ElaadNL/LowPowerLora-v4/Arduino_RFM95.kicad_pcb

## KiCad design Arduino_RFM95.kicad_pcb (2019-10-10)

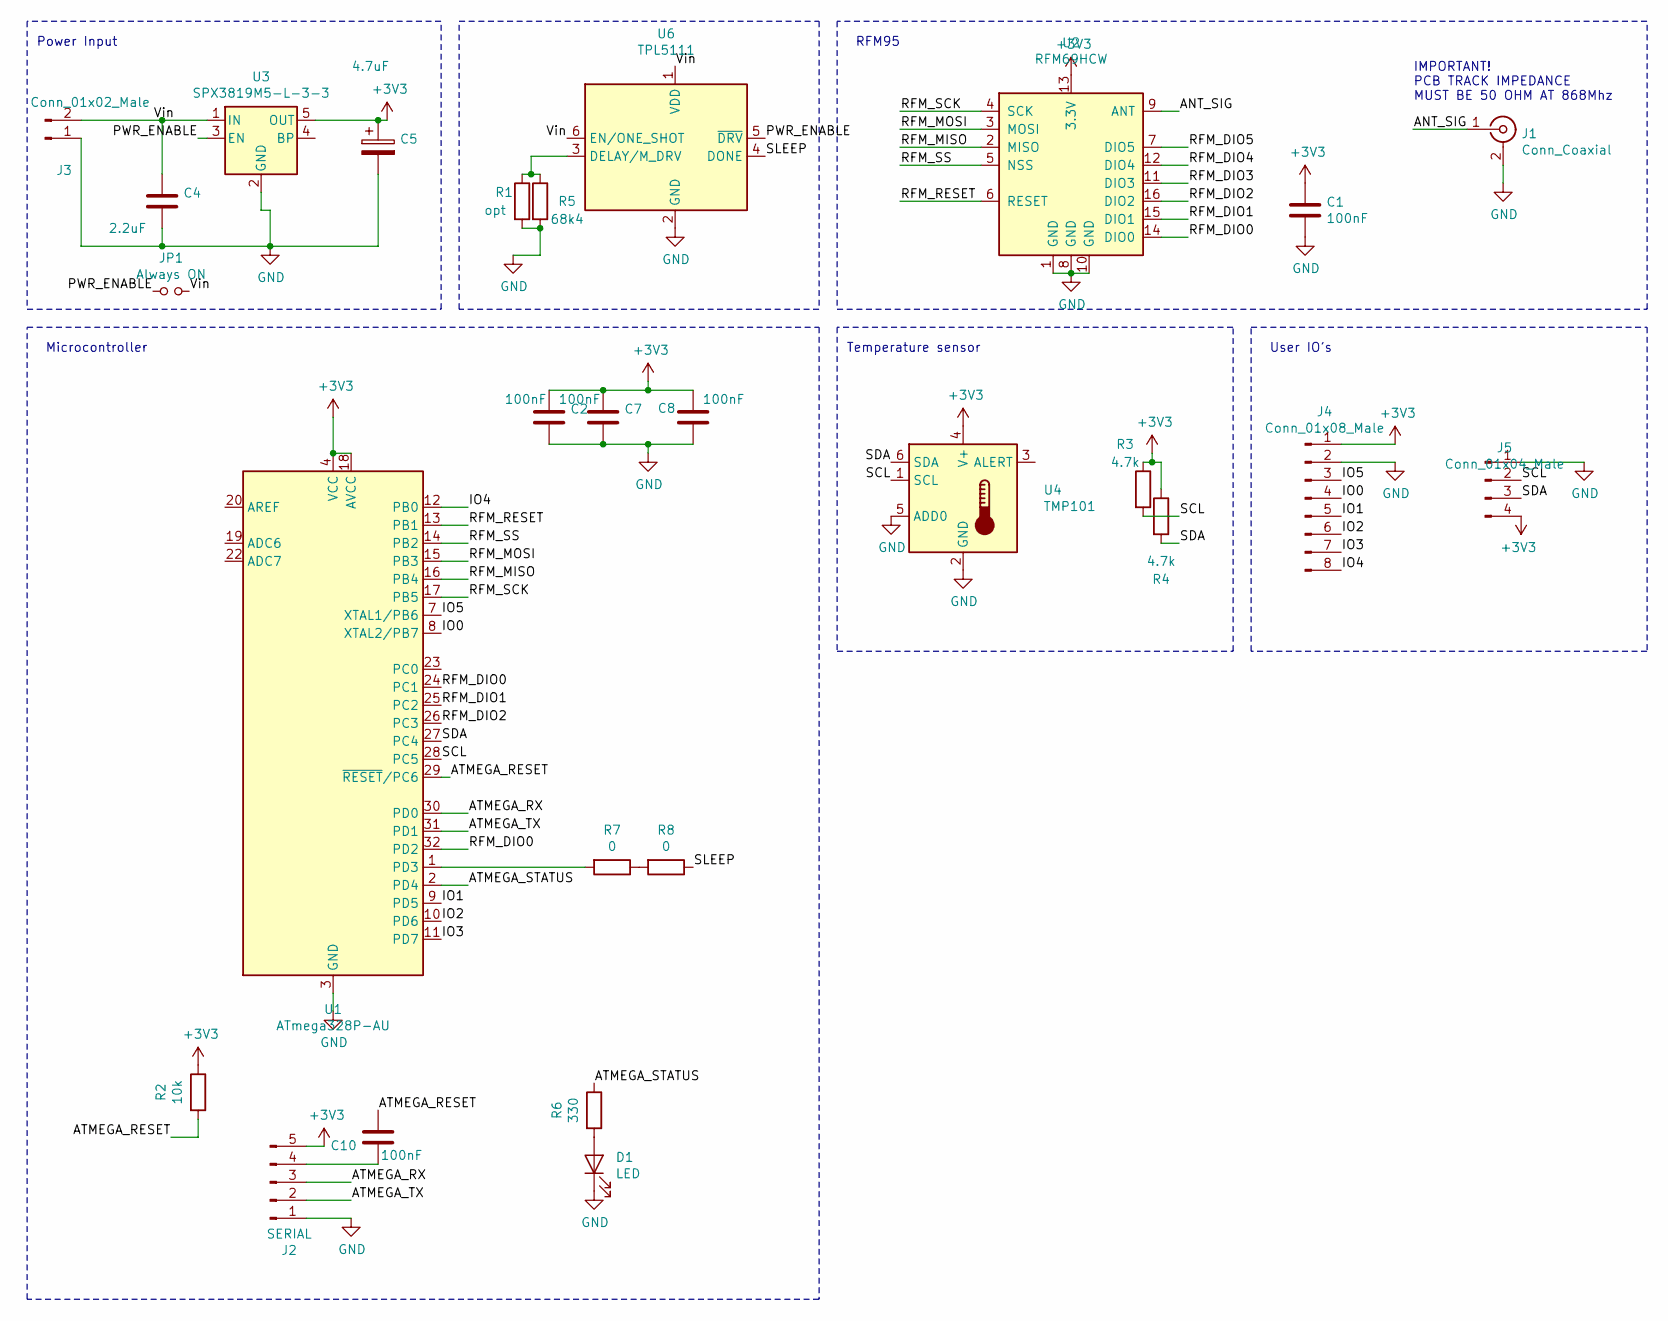
[picture p1: schematic Arduino_RFM95.sch, LowPowerLoraPCB]

Parts:
C1, C2, C7, C8, C10: 100nF; C_0805_2012Metric
C4: 2.2uF; C_0805_2012Metric
C5: 4.7uF; C_0805_2012Metric
D1: LED; LED_0805_2012Metric
J1: Conn_Coaxial; U.FL_Hirose_U.FL-R-SMT-1_Vertical
J2: SERIAL; PinHeader_1x05_P2.54mm_Horizontal
J3: Conn_01x02_Male; PinHeader_1x02_P2.54mm_Horizontal
J4: Conn_01x08_Male; PinHeader_1x08_P2.54mm_Vertical
J5: Conn_01x04_Male; PinHeader_1x04_P2.54mm_Vertical
JP1: Always ON; SolderJumper-2_P1.3mm_Open_RoundedPad1.0x1.5mm
R1: opt; R_0805_2012Metric
R2: 10k; R_0805_2012Metric
R3, R4: 4.7k; R_0805_2012Metric
R5: 68k4; R_0805_2012Metric
R6: 330; R_0805_2012Metric
R7: 0; R_1206_3216Metric
R8: 0; R_0805_2012Metric
U1: ATmega328P-AU; TQFP-32_7x7mm_P0.8mm
U2: RFM69HCW; HOPERF_RFM9XW_SMD
U3: SPX3819M5-L-3-3; SOT-23-5
U4: TMP101; SOT-23-6
U6: TPL5111; SOT-23-6

Connections:
+3V3: C1.2, C2.2, C5.1, C7.2, C8.2, J2.5, J4.1, J5.4, R2.1, R3.1, R4.1, U1.4 (VCC), U1.6 (VCC), U1.18 (AVCC), U2.13 (3.3V), U3.5 (OUT), U4.4 (V+)
/ANT_SIG: J1.1 (In), U2.9 (ANT)
/ATMEGA_RESET: C10.1, R2.2, U1.29 (~RESET~/PC6)
/ATMEGA_RX: J2.3, U1.30 (PD0)
/ATMEGA_STATUS: R6.1, U1.2 (PD4)
/ATMEGA_TX: J2.2, U1.31 (PD1)
/IO0: J4.4, U1.8 (XTAL2/PB7)
/IO1: J4.5, U1.9 (PD5)
/IO2: J4.6, U1.10 (PD6)
/IO3: J4.7, U1.11 (PD7)
/IO4: J4.8, U1.12 (PB0)
/IO5: J4.3, U1.7 (XTAL1/PB6)
/PWR_ENABLE: JP1.1, U3.3 (EN), U6.5 (~DRV)
/RFM_DIO0: U1.24 (PC1), U1.32 (PD2), U2.14 (DIO0)
/RFM_DIO1: U1.25 (PC2), U2.15 (DIO1)
/RFM_DIO2: U1.26 (PC3), U2.16 (DIO2)
/RFM_DIO3: U2.11 (DIO3)
/RFM_DIO4: U2.12 (DIO4)
/RFM_DIO5: U2.7 (DIO5)
/RFM_MISO: U1.16 (PB4), U2.2 (MISO)
/RFM_MOSI: U1.15 (PB3), U2.3 (MOSI)
/RFM_RESET: U1.13 (PB1), U2.6 (RESET)
/RFM_SCK: U1.17 (PB5), U2.4 (SCK)
/RFM_SS: U1.14 (PB2), U2.5 (NSS)
/SCL: J5.2, R3.2, U1.28 (PC5), U4.1 (SCL)
/SDA: J5.3, R4.2, U1.27 (PC4), U4.6 (SDA)
/SLEEP: R8.1, U6.4 (DONE)
/Vin: C4.2, J3.2, JP1.2, U3.1 (IN), U6.1 (VDD), U6.6 (EN/ONE_SHOT)
GND: C1.1, C2.1, C4.1, C5.2, C7.1, C8.1, D1.1 (K), J1.2 (Ext), J2.1, J3.1, J4.2, J5.1, R1.2, R5.2, U1.3 (GND), U1.5 (GND), U1.21 (GND), U2.1 (GND), U2.8 (GND), U2.10 (GND), U3.2 (GND), U4.2 (GND), U4.5 (ADD0), U6.2 (GND)
unnamed: C10.2, J2.4
unnamed: D1.2 (A), R6.2
unnamed: R1.1, R5.1, U6.3 (DELAY/M_DRV)
unnamed: R7.1, R8.2
unnamed: R7.2, U1.1 (PD3)

Notes on the sheet:
Power Input
RFM95
IMPORTANT! PCB TRACK IMPEDANCE MUST BE 50 OHM AT 868Mhz
Microcontroller
Temperature sensor
User IO’s

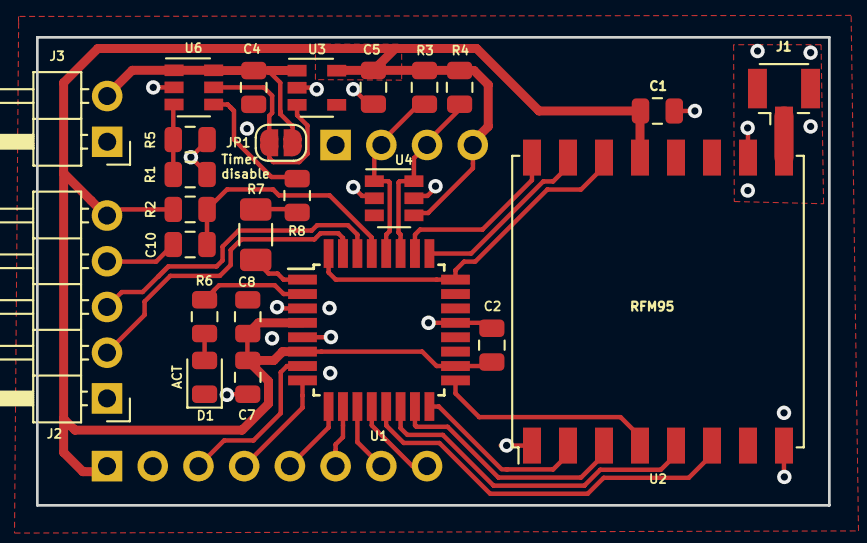
[picture p2: board Arduino_RFM95.kicad_pcb from above]

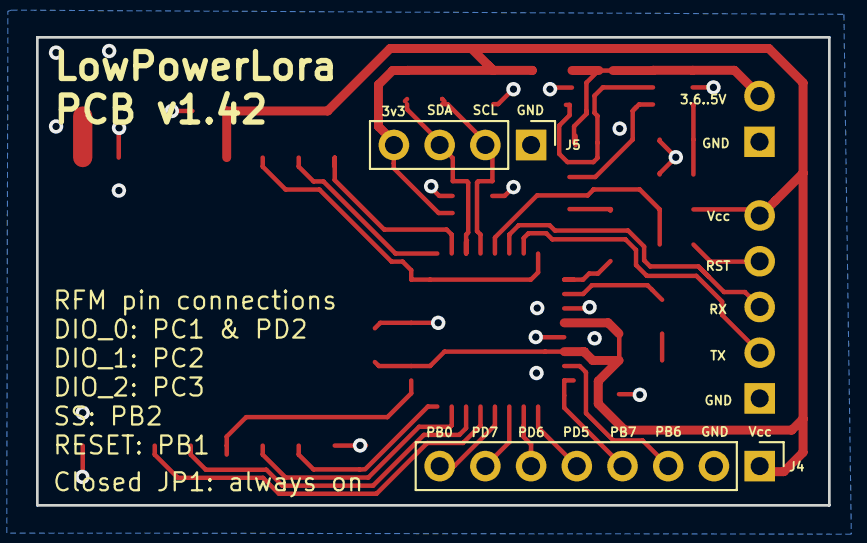
[picture p3: board Arduino_RFM95.kicad_pcb from below]

Board: 2 copper layers, 44.0 x 26.0 mm, 27 parts (2 on the bottom side), 31 nets.
